audenhuff/HD-VIS-T1-L-DIY-Budget-Thermal-Monocular-/README.md

# HD-VIS-T1-L-DIY-Budget-Thermal-Monocular-
DIY Budget Thermal Monocular
