audenhuff/HD-VIS-T1-L-DIY-Budget-Thermal-Monocular-/Printed Parts/Main Body.step

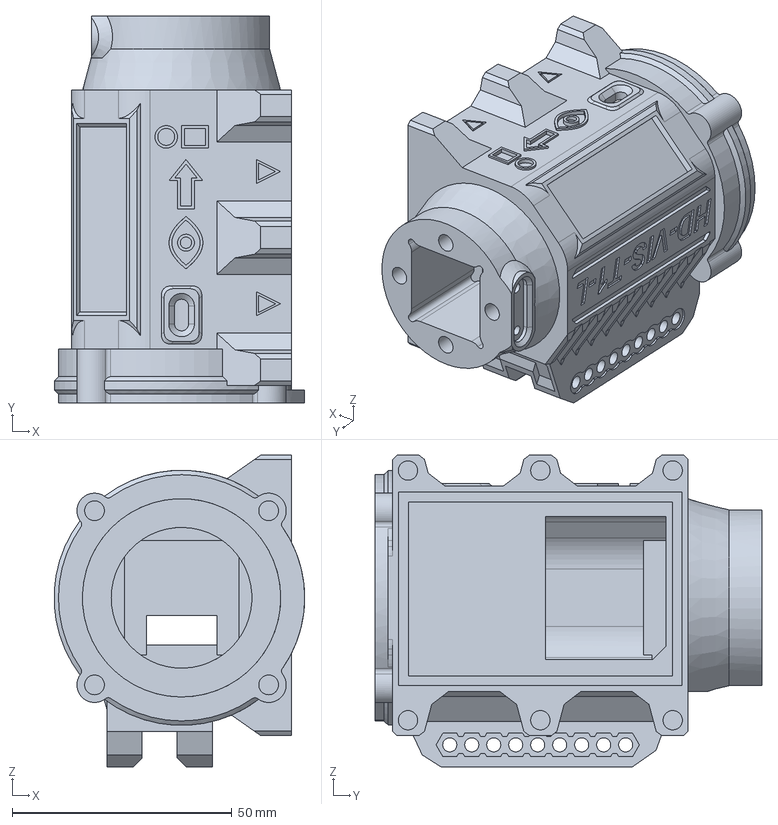
[picture p1: CAD file, 2025-02-09]
Printed Parts/Main Body.step
56.9 x 88.0 x 70.9 mm
