audenhuff/HD-VIS-T1-L-DIY-Budget-Thermal-Monocular-/Printed Parts/Ocular Lens Adjustment Knob.step

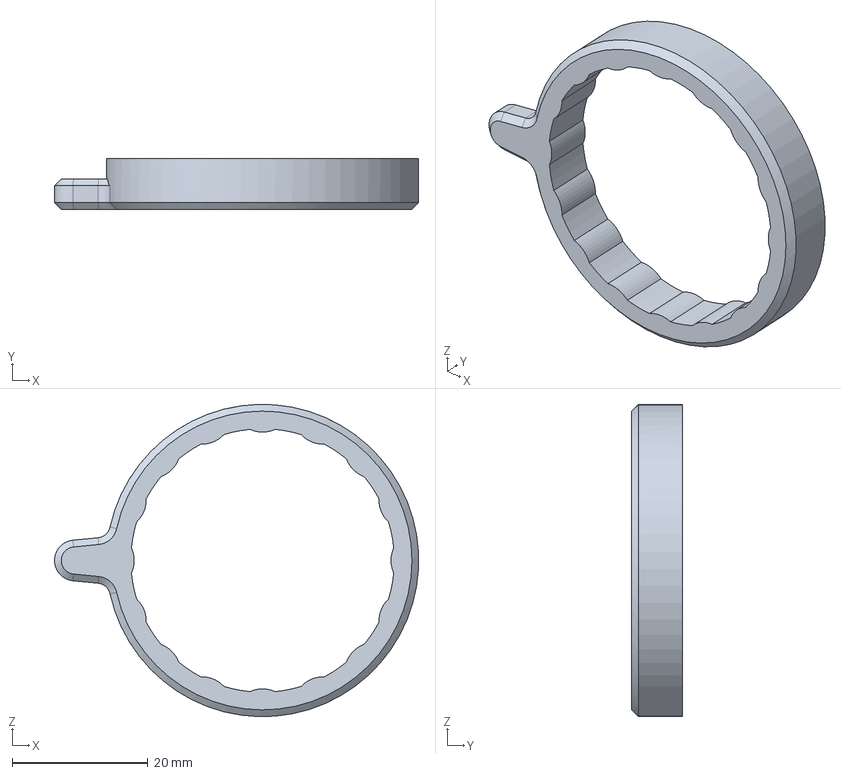
[picture p2: CAD file, 2025-02-09]
Printed Parts/Ocular Lens Adjustment Knob.step
53.6 x 7.50 x 46.0 mm
