audenhuff/HD-VIS-T1-L-DIY-Budget-Thermal-Monocular-/Printed Parts/Battery Compartment Seal.step

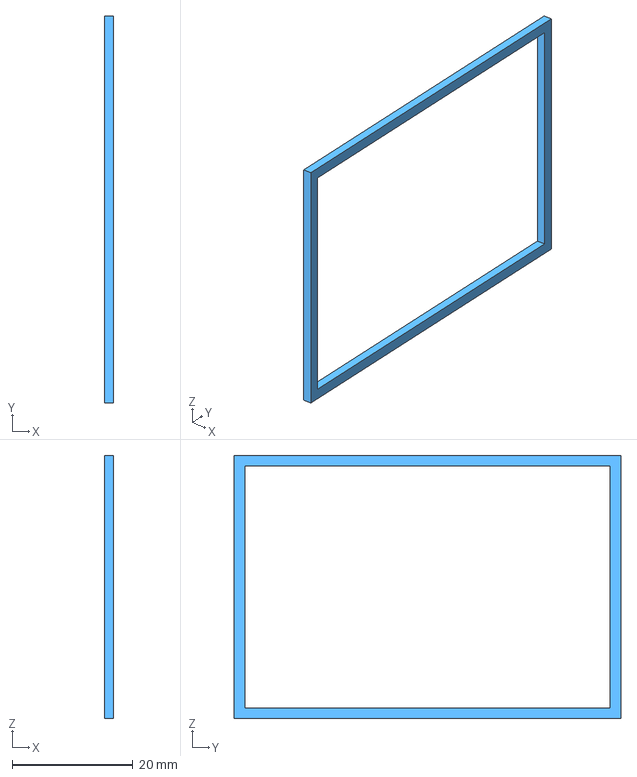
[picture p3: CAD file, 2025-02-09]
Printed Parts/Battery Compartment Seal.step
1.50 x 64.0 x 43.6 mm
