audenhuff/HD-VIS-T1-L-DIY-Budget-Thermal-Monocular-/Printed Parts/Camera End Cap Seal.step

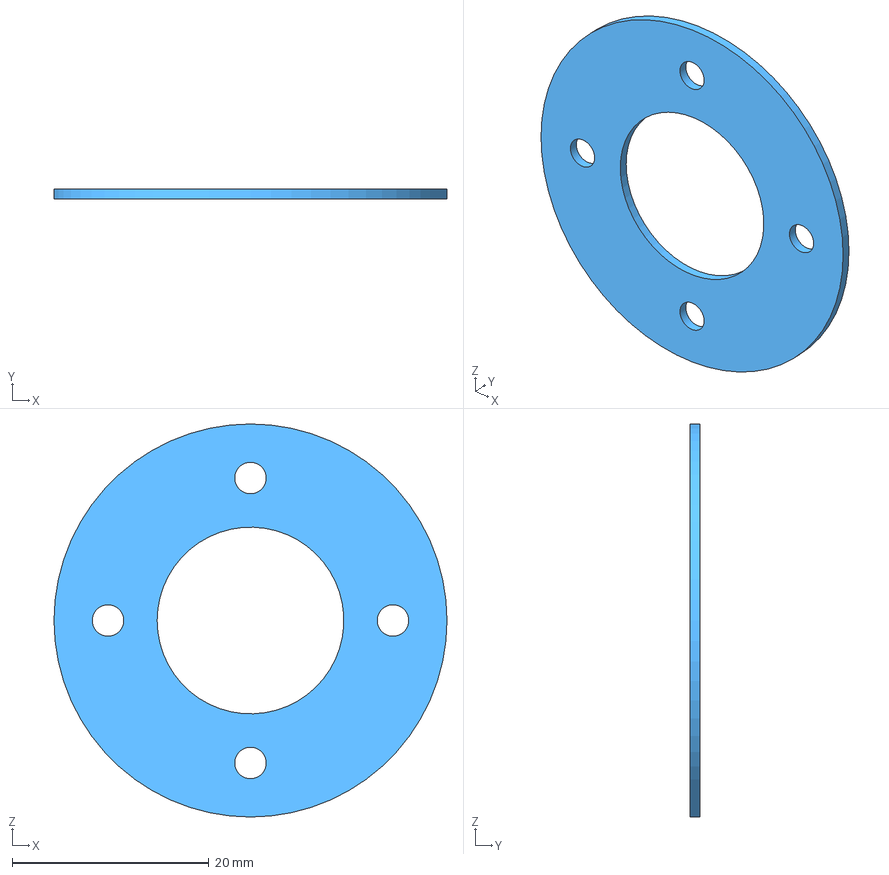
[picture p4: CAD file, 2025-02-09]
Printed Parts/Camera End Cap Seal.step
40.0 x 1.00 x 40.0 mm
