audenhuff/HD-VIS-T1-L-DIY-Budget-Thermal-Monocular-/Printed Parts/Cap Seal.step

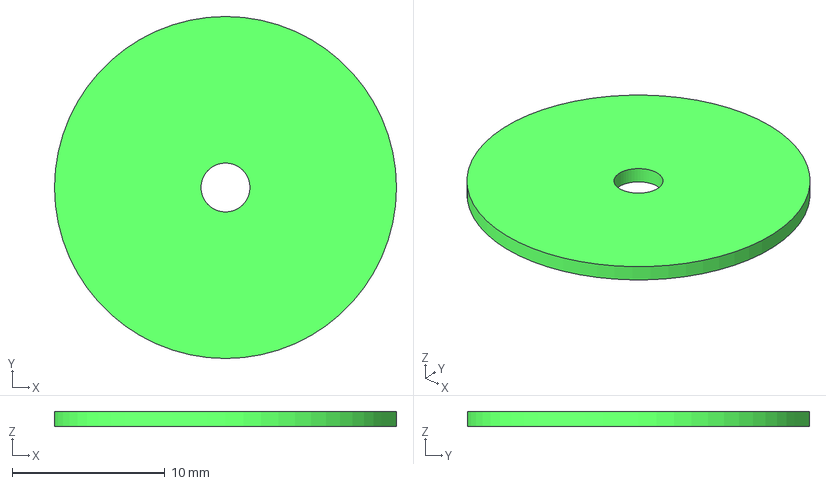
[picture p5: CAD file, 2025-02-09]
Printed Parts/Cap Seal.step
22.4 x 22.4 x 1.00 mm
