audenhuff/HD-VIS-T1-L-DIY-Budget-Thermal-Monocular-/Printed Parts/Button Cover.step

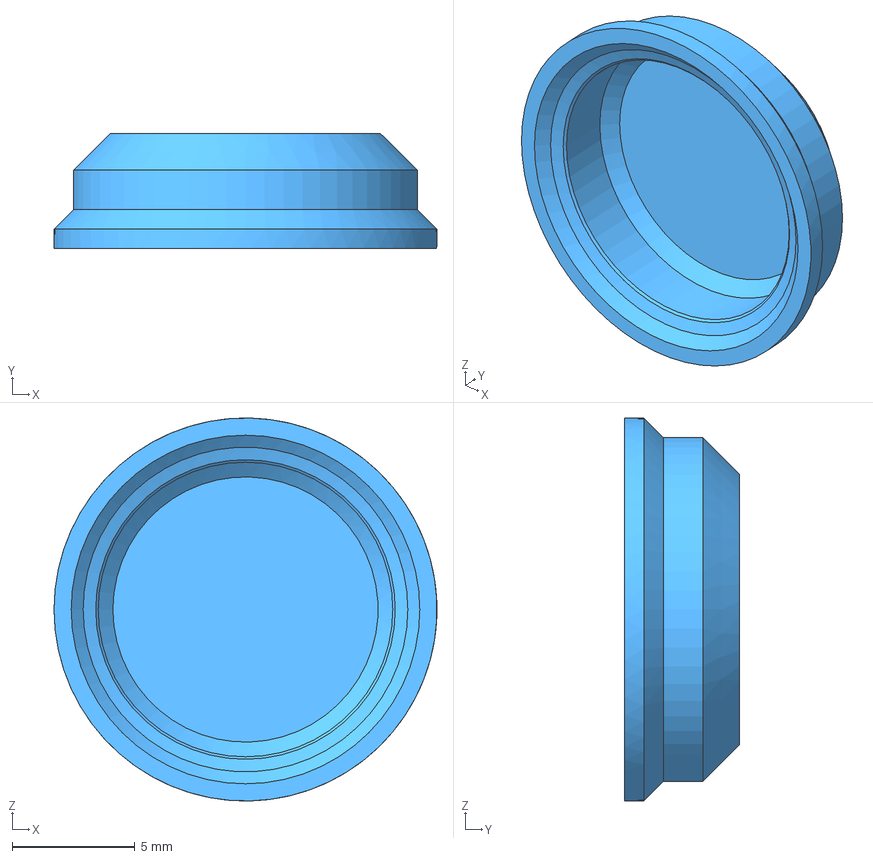
[picture p6: CAD file, 2025-02-09]
Printed Parts/Button Cover.step
15.6 x 4.70 x 15.6 mm
