audenhuff/HD-VIS-T1-L-DIY-Budget-Thermal-Monocular-/Printed Parts/Display Seal.step

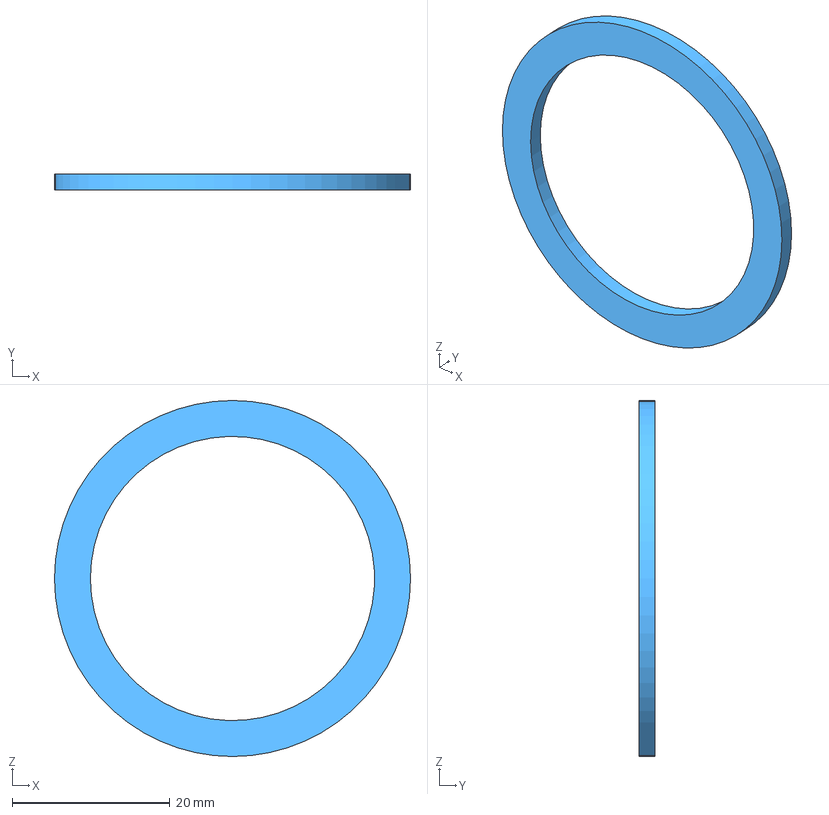
[picture p7: CAD file, 2025-02-09]
Printed Parts/Display Seal.step
45.1 x 2.00 x 45.1 mm
