audenhuff/HD-VIS-T1-L-DIY-Budget-Thermal-Monocular-/Printed Parts/Cap.step

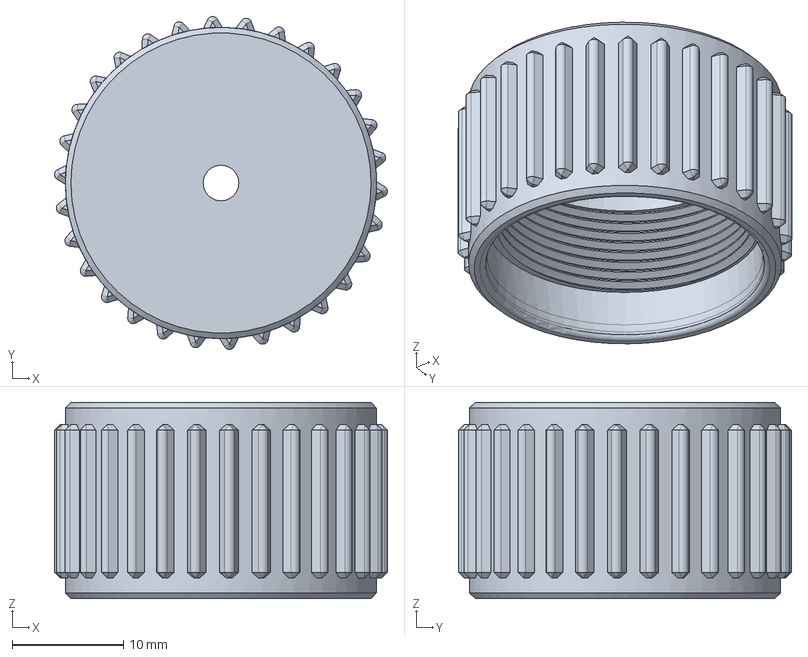
[picture p8: CAD file, 2025-02-09]
Printed Parts/Cap.step
30.0 x 30.0 x 17.7 mm
