audenhuff/HD-VIS-T1-L-DIY-Budget-Thermal-Monocular-/Printed Parts/Dovetail.step

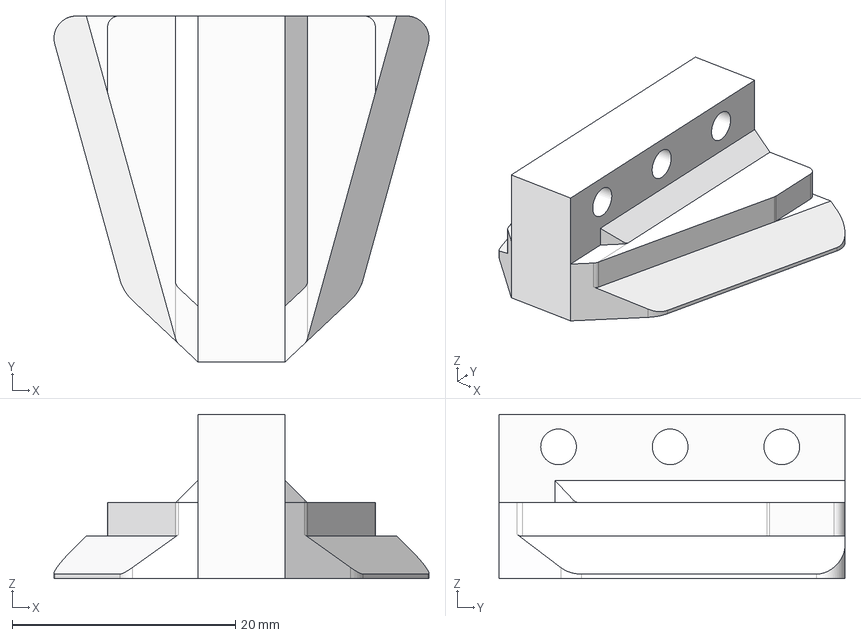
[picture p9: CAD file, 2025-02-09]
Printed Parts/Dovetail.step
33.6 x 31.0 x 14.7 mm
