audenhuff/HD-VIS-T1-L-DIY-Budget-Thermal-Monocular-/Printed Parts/Battery Housing.step

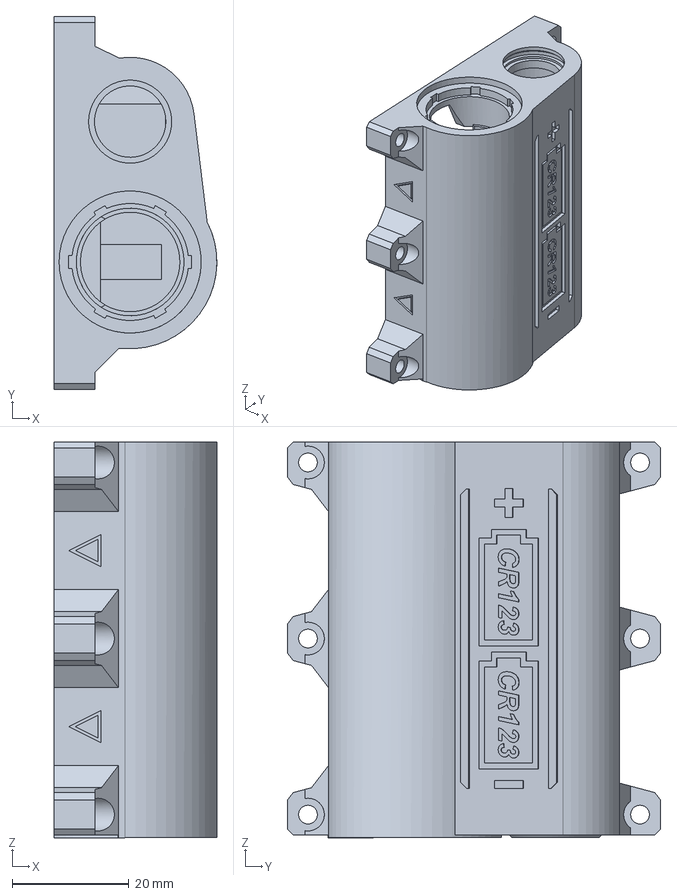
[picture p10: CAD file, 2025-02-09]
Printed Parts/Battery Housing.step
27.8 x 63.8 x 67.7 mm
