audenhuff/HD-VIS-T1-L-DIY-Budget-Thermal-Monocular-/Printed Parts/Ocular Knob Retainer.step

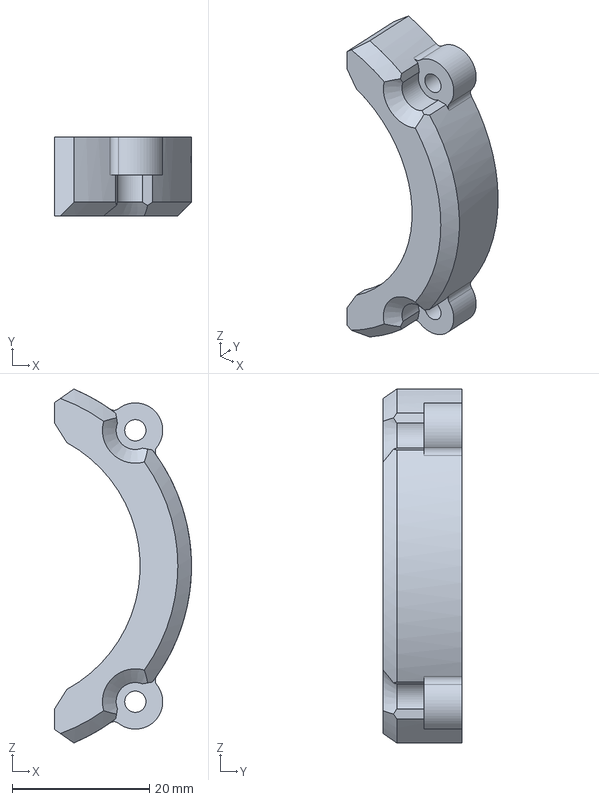
[picture p11: CAD file, 2025-02-09]
Printed Parts/Ocular Knob Retainer.step
20.0 x 11.5 x 51.6 mm
