audenhuff/HD-VIS-T1-L-DIY-Budget-Thermal-Monocular-/Printed Parts/Housing Sleeve Thread.step

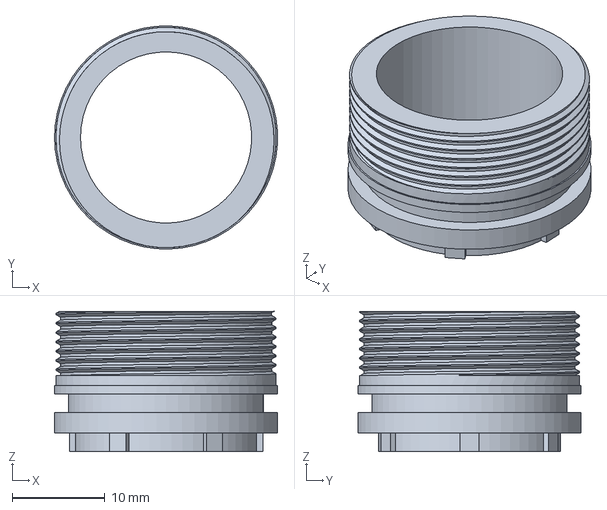
[picture p12: CAD file, 2025-02-09]
Printed Parts/Housing Sleeve Thread.step
24.0 x 24.0 x 15.1 mm
