audenhuff/HD-VIS-T1-L-DIY-Budget-Thermal-Monocular-/Printed Parts/Sleeve Seal.step

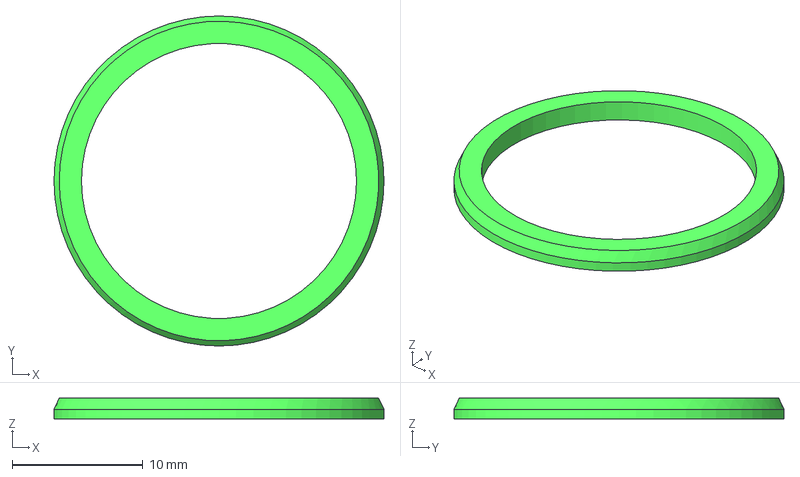
[picture p13: CAD file, 2025-02-09]
Printed Parts/Sleeve Seal.step
25.2 x 25.2 x 1.60 mm
