audenhuff/HD-VIS-T1-L-DIY-Budget-Thermal-Monocular-/Printed Parts/Camera End Cap.step

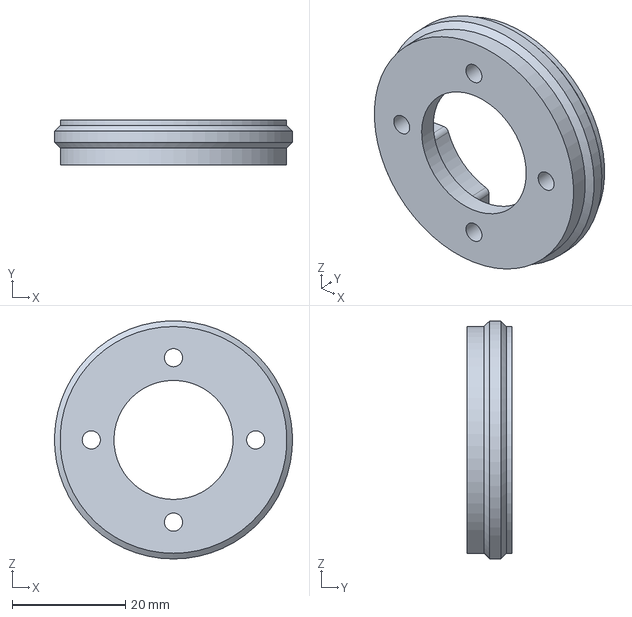
[picture p14: CAD file, 2025-02-09]
Printed Parts/Camera End Cap.step
42.0 x 8.00 x 42.0 mm
