audenhuff/HD-VIS-T1-L-DIY-Budget-Thermal-Monocular-/Printed Parts/Display Retainer.step

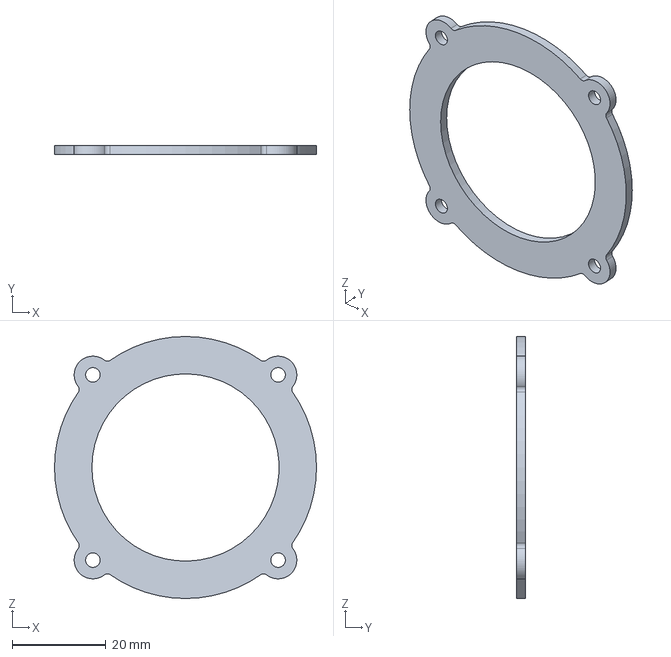
[picture p15: CAD file, 2025-02-09]
Printed Parts/Display Retainer.step
56.0 x 2.00 x 56.0 mm
