audenhuff/HD-VIS-T1-L-DIY-Budget-Thermal-Monocular-/Printed Parts/Thermal Camera Protective Cover.step

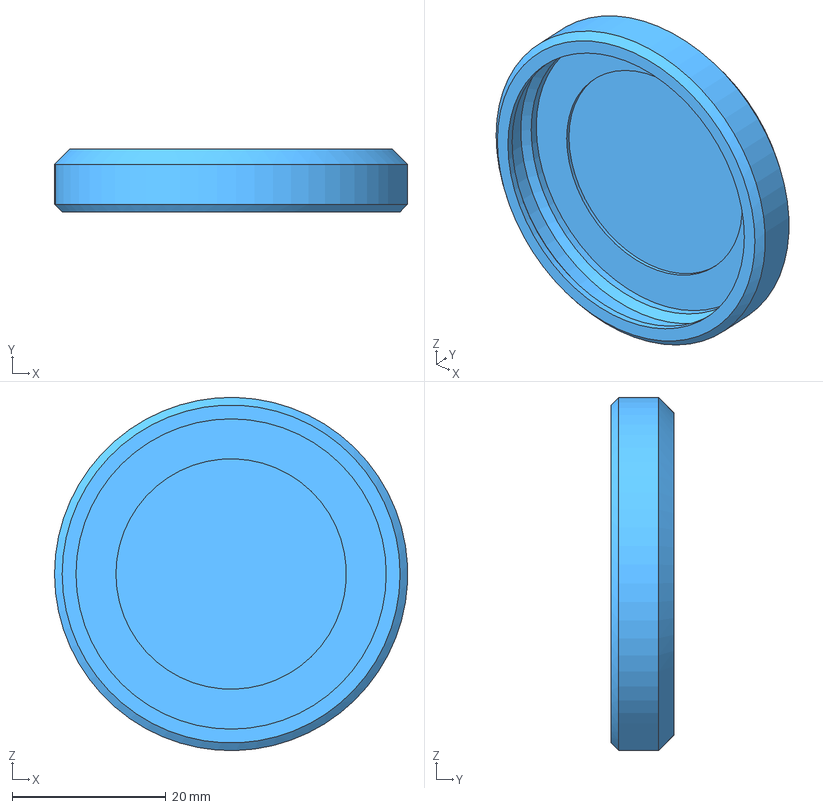
[picture p16: CAD file, 2025-02-09]
Printed Parts/Thermal Camera Protective Cover.step
46.0 x 8.20 x 46.0 mm
