audenhuff/HD-VIS-T1-L-DIY-Budget-Thermal-Monocular-/Printed Parts/Camera Retainer Bolts Seal.step

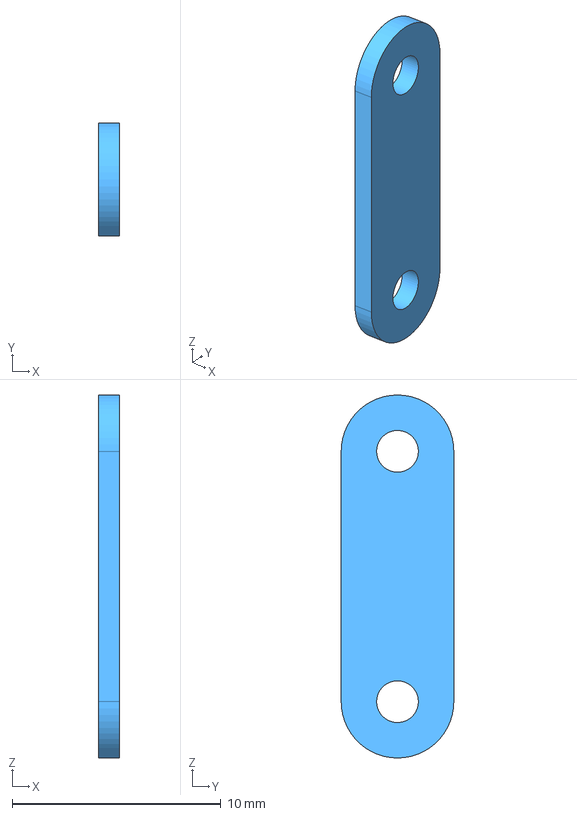
[picture p17: CAD file, 2025-02-09]
Printed Parts/Camera Retainer Bolts Seal.step
1.00 x 5.40 x 17.4 mm
